DegsTerin/Maths_Quiz_Game/hardware/electronics/maths-quiz-game-ocr.png

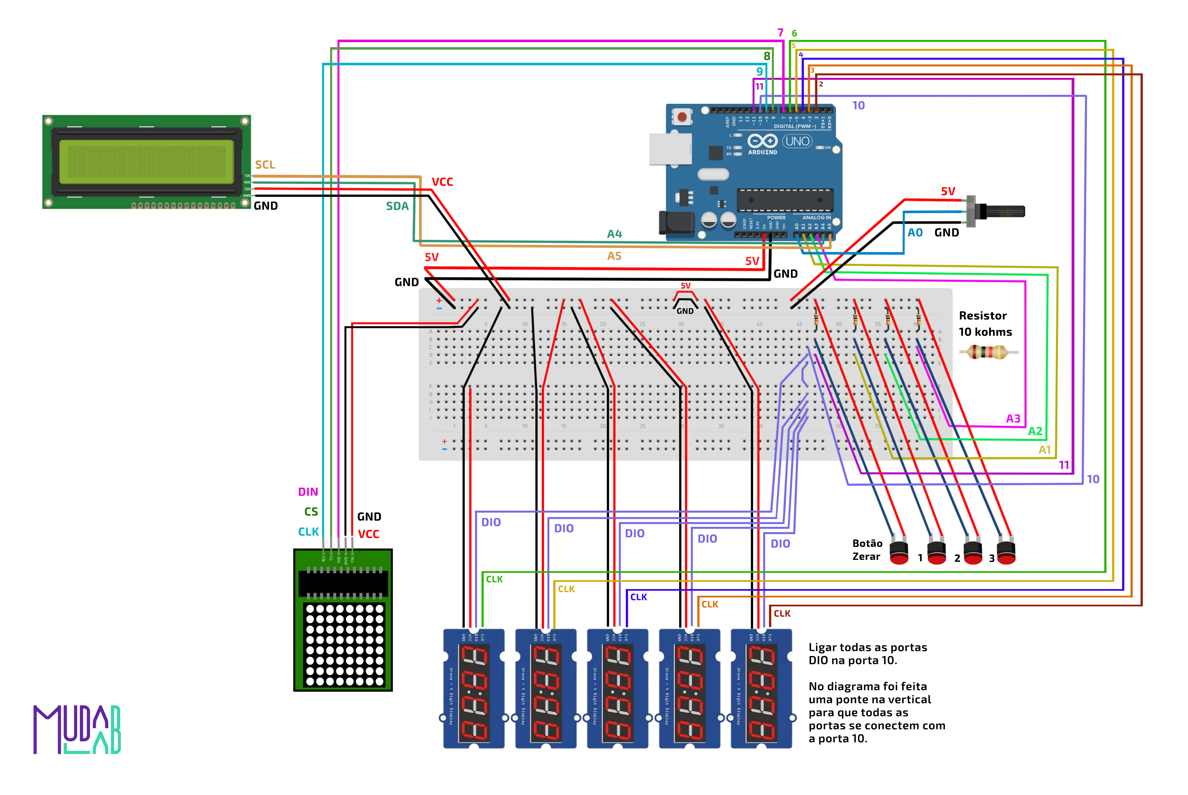
hardware/electronics/maths-quiz-game-ocr.png
