DegsTerin/Maths_Quiz_Game/docs/project-tutorial.docx

What You Will Need

The production of accessible educational materials can involve basic electronics knowledge and digital design. However, adaptations are always welcome based on the creativity and expertise of your school community to facilitate the construction and improvement of the material. Additionally, in some cases, alternative resources are also suggested.

To follow the steps in this tutorial, it is recommended that you seek assistance from a technical person within your school community or from institutions with technological expertise. If necessary, consult the list of basic programmes and tutorials below to understand how to operate the equipment, codes, and programmes required.

Access to digital fabrication equipment, such as laser cutters and 3D printers, can be obtained through partnerships with maker spaces and service providers in your municipality. For example, in São Paulo, there are FabLab’s available for free use by educators.

Materials

a) For making the mathematical box

• 1 MDF board, 3 mm thick, measuring 60 cm x 30 cm;

• Wood glue or instant adhesive;

• Masking tape.

b) For the electronic components of the sound module:

• 1 Arduino Uno or Nano;

• Arduino cable;

• 1 5V, 2A power supply;

• 1 breadboard;

• 3 arcade buttons;

• 1 10mm pushbutton;

• 4 10 kohm resistors;

• 2 LEDs;

• 1 potentiometer;

• Jumper wires;

• 4 TM1637 clock displays;

• 1 8x8 LED matrix with MAX7219 chip;

• 1 16x2 LED display with I2C chip;

• Insulating tape;

• Hot glue.

c) Tools and utensils used:

• Laser cutter;

• Illustrator CS5 or other vector software such as Inkscape (for laser cutting);

• Cutting pliers;

• Wire stripper;

• Soldering iron;

Shall We Begin?

Cutting the device:

● Step 1: Download the templates and unzip the files. Open the "Vetor" folder and send the file compatible with your preferred vector program to the laser cutter. These are adjusted for cutting on a 3 mm MDF board.

You can find laser cutters for free use at FabLab’s or maker spaces and service providers in your municipality.

Alternatively, you can use the PDF file as a reference to build this educational material on thick cardboard or manually cut the MDF.

● Step 2: Simulate the fitting of the cut pieces using masking tape.

● Step 3: Apply instant glue to the joints of the structure for permanent assembly. Be careful not to glue the top part of the hat. Access to the internal part will be important.

Creating the Electronic Scheme

● Step 4: Download the programme, locate the "Arduino" folder among the downloaded files, and copy the ".ico" folder to your computer. Copy the "LiquidCrystal_I2C" and "TM1637_Driver" folders from within the "libraries" folder to the "libraries" folder in the Arduino installation directory on your computer. Open the file ".ino".

● Step 5: Assemble the electronic circuit on the breadboard following the "MPA-Matematica.pdf" file located in the "Electronics" folder within the materials you downloaded.

● Step 6: After assembling the electronic circuit, attach the breadboard to the back of the device using hot glue. If preferred, components can be soldered onto a phenolic board.

Now, Just Use!

Your accessible educational material is ready. Use it with your students in the common room and share your practice on DIVERSA.

The device offers three difficulty levels. Turn the potentiometer to select the difficulty. The digits and the mathematical operation will be chosen, and you need to select the correct option.

Need Help?

Check out our suggested programmes and tutorials on basic electronics and digital design.

Inkscape

What it is: Free software for creating and editing vector images and documents.

Learn to use Inkscape through a text tutorial on an external website.

Google SketchUp

What it is: Software for creating 3D models on a computer.

Learn to use Google SketchUp through a text tutorial and a basic video course on external sites.

Blender

What it is: A computer program for modelling, animation, texturing, compositing, rendering, video editing, and creating interactive 3D applications such as games and presentations.

Learn to use Blender through a text tutorial and an essential video course on external sites.

Arduino

What it is: An open-source hardware prototyping platform with a single board, used for creating projects with a standard programming language, primarily C/C++.

Learn to use Arduino through a text tutorial and an introductory video course on external sites.
