DegsTerin/Maths_Quiz_Game/tutorial/Tutorial.docx

O que você vai precisar

A fabricação de materiais pedagógicos acessíveis pode levar em consideração conhecimentos de eletrônica básica e desenho digital. Entretanto, são sempre bem-vindas adaptações de acordo com a criatividade e o conhecimento da sua comunidade escolar para viabilizar a construção e o aprimoramento do material. Além disso, em alguns casos, também sugerimos recursos alternativos.

Para executar os passos deste tutorial, indicamos que você procure a ajuda de uma pessoa técnica de sua comunidade escolar ou de instituições que possuam conhecimentos em tecnologia. Caso seja preciso, consulte a lista de programas e tutoriais básicos abaixo para entender como usar os equipamentos, códigos e programas necessários.

Para ter acesso a equipamentos de fabricação digital, como cortadoras a laser e impressoras 3D, você pode buscar parcerias em espaços voltados para o movimento maker e prestadores de serviço de seu município. Na cidade de São Paulo, por exemplo, há FabLabs Livres Site externo para uso gratuito de educadores.

Materiais

a) Para fazer a caixa matemática

• 1 placa de MDF de 3 mm de 60 cm x 30 cm;

• Cola para madeira ou instantânea;

• Fita crepe.

b) Para fazer a eletrônica da parte sonora:

• 1 arduino uno ou nano;

• Cabo para arduino;

• 1 fonte de 5V e 2A;

• 1 protoboard;

• 3 botões arcade;

• 1 botão pushbutton 10mm;

• 4 resistores de 10 kohm;

• 2 leds;

• 1 potenciômetro;

• jumpers;

• 4 display relógio TM1637;

• 1 Matriz de Led 8x8 com chip MAX7219

• 1 display de Led 16x2 com chip I2C

• Fita isolante;

• Cola quente.

c) Ferramentas e utensílios utilizados:

• Cortadora a laser;

• Software Illustrator CS5 ou outro vetorial, como o inkScape (para realizar o corte a laser);

• Alicate de corte;

• Descascador de fio;

• Ferro de solda;

Vamos começar?

Cortando o dispositivo:

● Passo 1: Faça o download dos MOLDES e descompacte os arquivos. Abra a pasta “Vetor” e envie o arquivo compatível com o seu programa de vetor preferido para uma cortadora a laser. Eles estão ajustados para o corte na placa de MDF de 3 mm de espessura.

Você pode encontrar cortadoras a laser para uso gratuito em FabLabs ou em espaços voltados para o movimento maker e prestadores de serviço de seu município.

Como alternativa, você pode usar o arquivo em PDF como referência para construir este material pedagógico em uma placa de papelão grosso ou mesmo realizar o corte em MDF manualmente.

● Passo 2: Simule o encaixe das peças cortadas usando uma fita crepe.

● Passo 3: Passe cola instantânea nas junções da estrutura para fazer a colagem definitiva. Fique atento para não colar a parte superior da cartola. Será importante ter acesso à parte interna.

Criando o esquema eletrônico

● Passo 4: Baixe o programa, procure “Arduino” entre as pastas baixadas e copie a pasta “MPA-Matematica” para o seu computador. Copie as pastas “LiquidCrystal_I2Ci” e "TM1637_Driver" que estão dentro da pasta “libraries” para a pasta “libraries” no diretório onde está instalado o Arduino no seu computador. Abra o arquivo “MPA-Matematica.ino”.

● Passo 5: Monte o circuito eletrônico na protoboard seguindo o arquivo “MPA-Matematica.pdf” dentro da pasta “Eletrônica”, disponível entre os materiais que você baixou.

● Passo 6: Depois de montar o circuito eletrônico, cole com cola quente a protoboard no fundo do dispositivo. Se desejar, você pode soldar os componentes em uma placa de fenolite.

Agora é só usar!

Seu material pedagógico acessível está pronto. Aproveite o material com suas alunas e seus alunos na sala comum e compartilhe sua prática no DIVERSA.

O dispositivo tem 3 tipos de dificuldade. Gire o ponteciômetro para selecionar a dificuldade. Os dígitos e a operação matemática serão selecionados e você precisa selecionar a opção correta.

Precisa de ajuda?

Confira nossas sugestões de programas e tutoriais sobre eletrônica básica e desenho digital.

Inkscape

O que é: software livre de criação e edição de imagens e documentos vetoriais.

Aprenda a usar o Inkscape em um tutorial de texto Site externo.

Google Sketchup

O que é: software de criação de modelos em 3D no computador.

Aprenda a usar o Google Sketchup em um tutorial de texto Site externo e no curso básico em vídeo Site externo.

Blender

O que é: programa de computador para modelagem, animação, texturização, composição, renderização, edição de vídeo e criação de aplicações interativas em 3D, tais como jogos, apresentações e outros.

Aprenda a usar o Blender em um tutorial de texto Site externo e no curso essencial em vídeo Site externo.

Arduino

O que é: plataforma de prototipagem eletrônica de hardware livre e de placa única, para criação é utilizada uma linguagem de programação padrão e é essencialmente C/C++.

Aprenda a usar o Arduino em um tutorial de texto Site externo e no curso introdutório em vídeo Site externo.
