DegsTerin/Maths_Quiz_Game/(commit log)

2026-03-05 release: v1.1.0 with INPUT_PULLUP wiring and docs update
2026-03-05 Fix TM1637 decimal formatting for integers and leading zero
    [maths-quiz-game-en-gb.ino, maths-quiz-game-pt-br.ino, sketch.ino]
2026-03-06 Reorganize integer sketches into separate Arduino folders
2026-03-06 Update README with new badges
    Added additional badges for sponsorship, board, simulation, and release version.
2026-03-09 Adjust bundled Arduino library sources
